ManitoSecurity/PCBDesign/ManufacturedBoards/mar25/ManitoBoardFinal/ManitoBoardFinal.brd

## EAGLE design ManufacturedBoards/mar25/ManitoBoardFinal/ManitoBoardFinal.brd (2015-03-25)

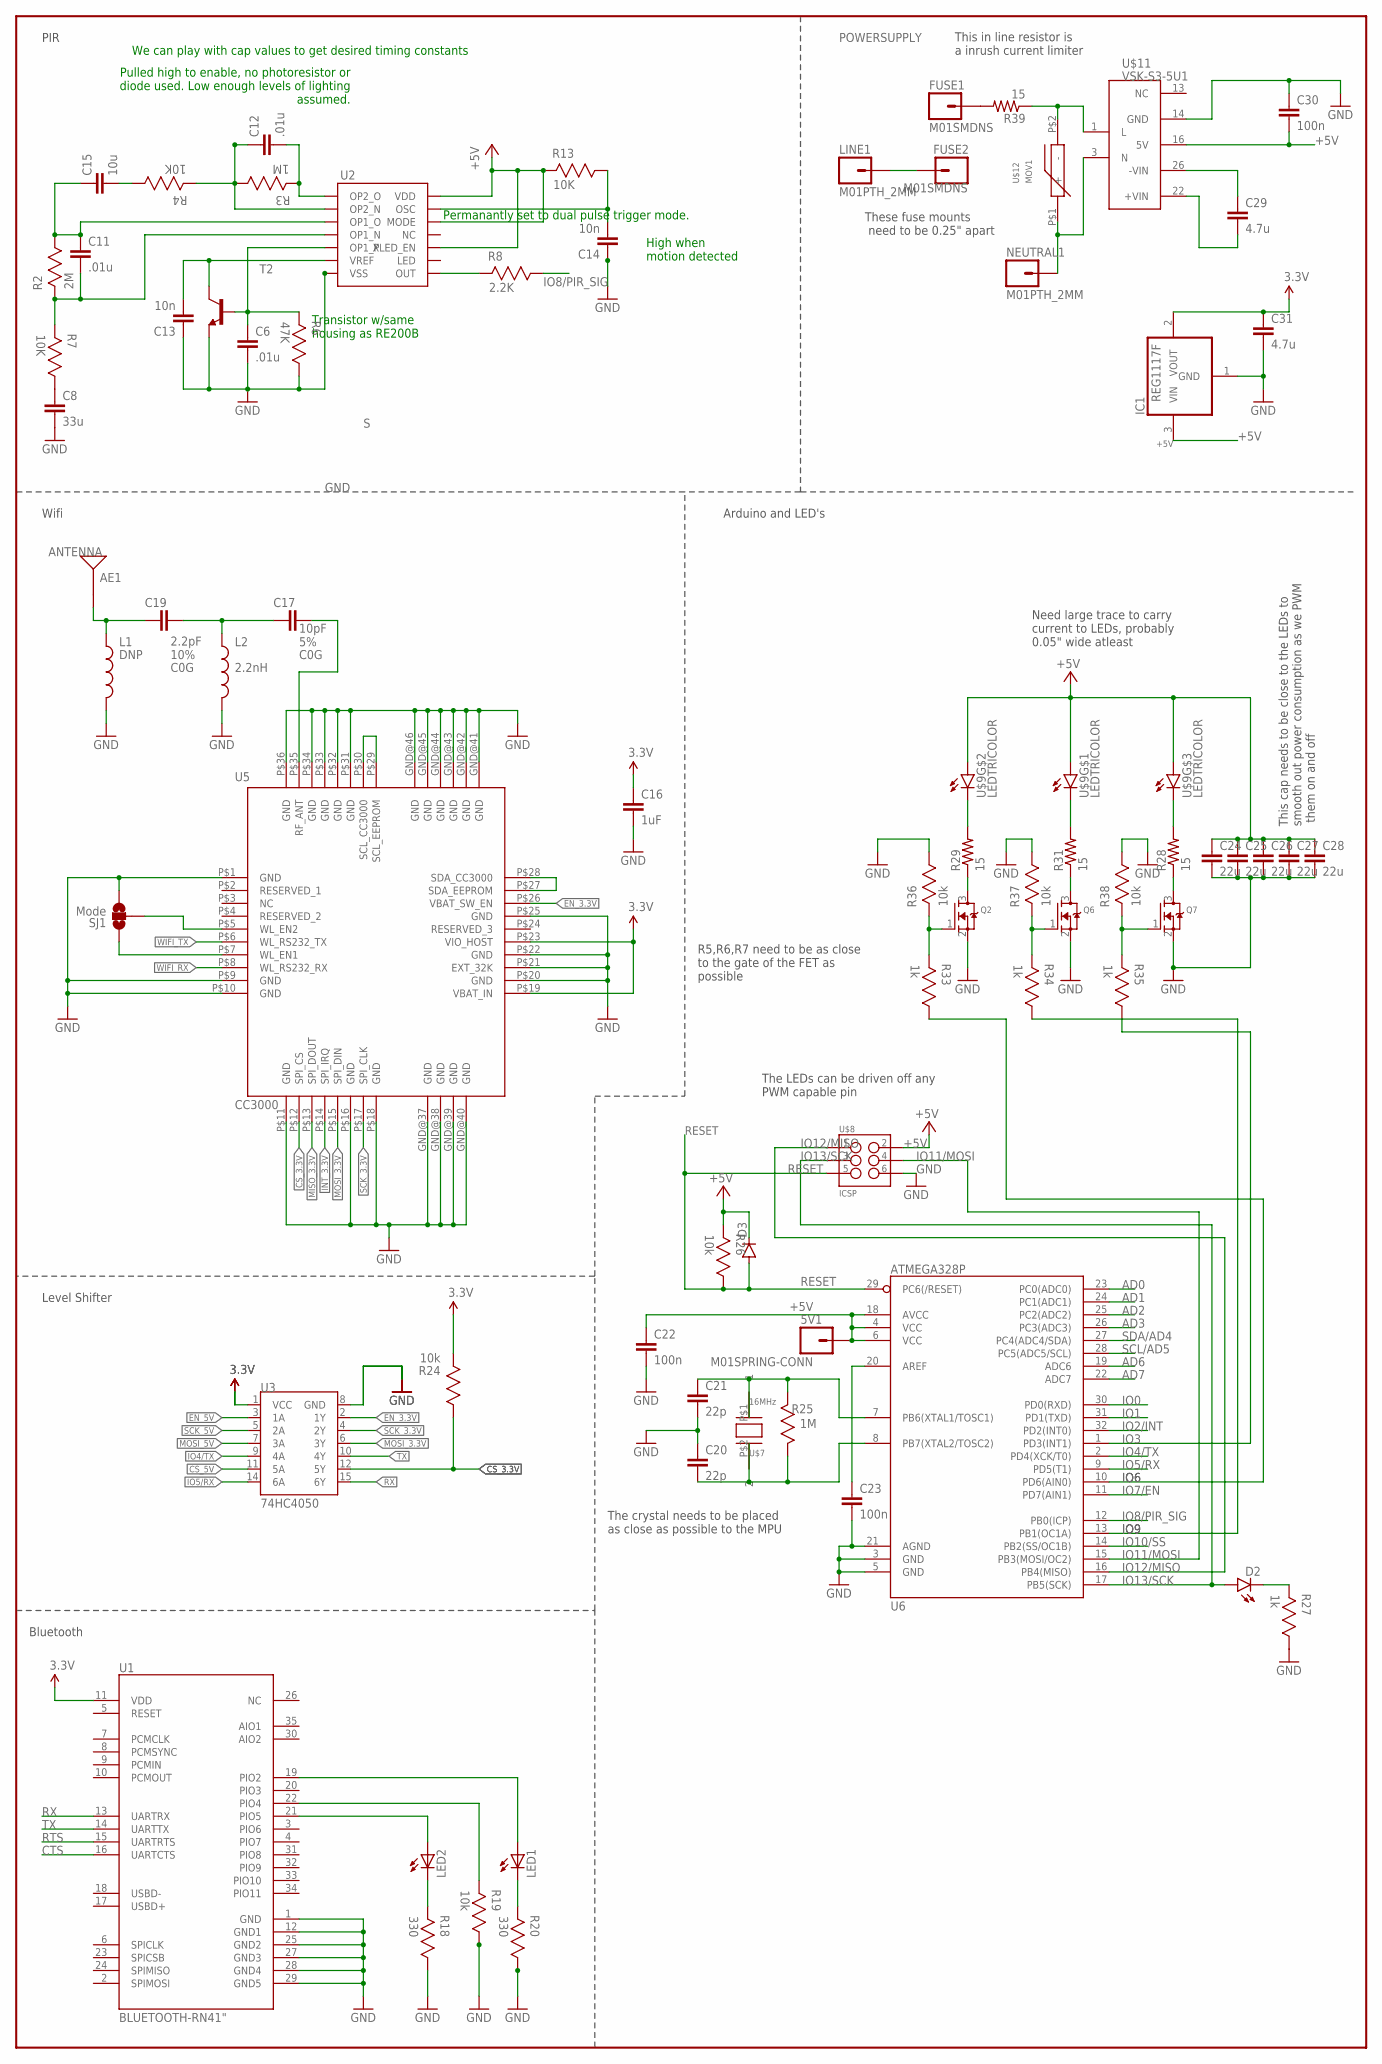
[picture p1: schematic ManitoBoardFinal.sch]

Parts:
5V1: M01SPRING-CONN; SPRING-CONNECTOR
AE1: ANTENNA; ANTENNA-CHIP_2500AT44M0400
C6, C11, C12: .01u; 0805
C8: 33u; 0805
C13, C14: 10n; 0805
C15: 10u; 0805
C16: 1uF; 0805
C17: 10pF; 0603-CAP
C19: 2.2pF; 0603-CAP
C20, C21: 22p; 0603-CAP
C22, C23, C30: 100n; 0603-CAP
C24, C25, C26, C27, C28: 22u; 0603-CAP
C29: 4.7u; AXIAL-5MM
C31: 4.7u; 0603-CAP
D2: LED-YELLOW0603; LED-0603
D3: DIODESOD123; SOD-123
FUSE1, FUSE2: M01SMDNS; 1X01NS
IC1: REG1117F; DD-3
L1: DNP; 0603
L2: 2.2nH; 0603
LED1, LED2: LED_ESML0603; LED_SML0603
LINE1: M01PTH_2MM; 1X01_2MM
NEUTRAL1: M01PTH_2MM; 1X01_2MM
Q2, Q6, Q7: MOSFET-NREFLOW; SOT23
R2: 2M; 0603RESISTOR
R3, R25: 1M; 0603RESISTOR
R4, R7, R13: 10K; 0603RESISTOR
R6: 47K; 0603RESISTOR
R8: 2.2K; 0603RESISTOR
R18, R20: 330; 0603RESISTOR
R19, R24, R26, R36, R37, R38: 10k; 0603RESISTOR
R27, R33, R34, R35: 1k; 0603RESISTOR
R28, R29, R31, R39: 15; AXIAL-0.6
SJ1: Mode; SJ_3_PASTE1&2
T2: -NPN-TO5; TO5
U1: BLUETOOTH-RN41"; RN41
U2: NCS36000; SO14
U3: 74HC4050; SO016
U5: CC3000; QFN-46_CC3000
U6: ATMEGA328P; TQFP32-08
U$7: 16MHz; SMDCRYSTAL
U$8: ICSP; 2X3-ICSP
U$9: LEDTRICOLOR; TRICOLORLED
U$11: VSK-S3-5U1; VSK-S3-DCAC
U$12: MOV1; MOV

Connections:
3.3V: C16.1, C31.1, IC1.2 (VOUT), R24.2, U1.11 (VDD), U3.1 (VCC), U5.P$19 (VBAT_IN), U5.P$23 (VIO_HOST)
+5V: 5V1.P$2, C22.1, C24.1, C25.1, C26.1, C27.1, C28.1, C30.2, D3.C, IC1.3 (VIN), R13.2, R26.2, U2.10 (XLED_EN), U2.12 (MODE), U2.14 (VDD), U6.4 (VCC), U6.6 (VCC), U6.18 (AVCC), U$8.2 (+5V), U$9.A1 (A), U$9.A2 (A), U$9.A3 (A), U$11.16 (5V)
AD0: U6.23 (PC0(ADC0))
AD1: U6.24 (PC1(ADC1))
AD2: U6.25 (PC2(ADC2))
AD3: U6.26 (PC3(ADC3))
AD6: U6.19 (ADC6)
AD7: U6.22 (ADC7)
CS_3.3V: R24.1, U3.12 (5Y), U5.P$12 (SPI_CS)
CS_5V: U3.11 (5A)
CTS: U1.16 (UARTCTS)
EN_3.3V: U3.2 (1Y), U5.P$26 (VBAT_SW_EN)
EN_5V: U3.3 (1A)
GND: C6.2, C8.2, C13.1, C14.1, C16.2, C20.1, C21.2, C22.2, C23.2, C24.2, C25.2, C26.2, C27.2, C28.2, C30.1, C31.2, IC1.1 (GND), L1.2, L2.2, Q2.2 (S), Q6.2 (S), Q7.2 (S), R6.1, R18.1, R19.1, R20.1, R27.1, R36.1, R37.1, R38.1, SJ1.3, T2.1 (E), U1.1 (GND), U1.12 (GND1), U1.25 (GND2), U1.27 (GND3), U1.28 (GND4), U1.29 (GND5), U2.7 (VSS), U3.8 (GND), U5.GND@37 (GND), U5.GND@38 (GND), U5.GND@39 (GND), U5.GND@40 (GND), U5.GND@41 (GND), U5.GND@42 (GND), U5.GND@43 (GND), U5.GND@44 (GND), U5.GND@45 (GND), U5.GND@46 (GND), U5.P$1 (GND), U5.P$9 (GND), U5.P$10 (GND), U5.P$11 (GND), U5.P$16 (GND), U5.P$18 (GND), U5.P$20 (GND), U5.P$21 (EXT_32K), U5.P$22 (GND), U5.P$25 (GND), U5.P$31 (GND), U5.P$32 (GND), U5.P$33 (GND), U5.P$34 (GND), U5.P$36 (GND), U6.3 (GND), U6.5 (GND), U6.21 (AGND), U$8.6 (GND), U$11.14 (GND)
INT_3.3V: U5.P$14 (SPI_IRQ)
IO0: U6.30 (PD0(RXD))
IO1: U6.31 (PD1(TXD))
IO2/INT: U6.32 (PD2(INT0))
IO3: R35.1, U6.1 (PD3(INT1))
IO4/TX: U3.9 (4A), U6.2 (PD4(XCK/T0))
IO5/RX: U3.14 (6A), U6.9 (PD5(T1))
IO6: R33.1, U6.10 (PD6(AIN0))
IO7/EN: U6.11 (PD7(AIN1))
IO8/PIR_SIG: R8.1, U6.12 (PB0(ICP))
IO9: R34.1, U6.13 (PB1(OC1A))
IO10/SS: U6.14 (PB2(SS/OC1B))
IO11/MOSI: U6.15 (PB3(MOSI/OC2)), U$8.4 (MOSI)
IO12/MISO: U6.16 (PB4(MISO)), U$8.1 (MISO)
IO13/SCK: D2.A, U6.17 (PB5(SCK)), U$8.3 (SCK)
MISO_3.3V: U5.P$13 (SPI_DOUT)
MOSI_3.3V: U3.6 (3Y), U5.P$15 (SPI_DIN)
MOSI_5V: U3.7 (3A)
unnamed: LED2.C, R18.2
unnamed: C13.2, T2.3 (C), U2.6 (VREF)
unnamed: C11.1, C15.1, R2.1, U2.3 (OP1_O)
unnamed: C11.2, R2.2, R7.2, U2.4 (OP1_N)
unnamed: C12.1, R3.1, R4.2, U2.2 (OP2_N)
unnamed: LED1.C, R20.2
unnamed: C12.2, R3.2, U2.1 (OP2_O)
unnamed: C8.1, R7.1
unnamed: LED2.A, U1.21 (PIO5)
unnamed: R19.2, U1.22 (PIO4)
unnamed: LED1.A, U1.19 (PIO2)
unnamed: C15.2, R4.1
unnamed: C14.2, R13.1, U2.13 (OSC)
unnamed: R8.2, U2.8 (OUT)
unnamed: SJ1.2, U5.P$5 (WL_EN2)
unnamed: SJ1.1, U5.P$7 (WL_EN1)
unnamed: U5.P$27 (SDA_EEPROM), U5.P$28 (SDA_CC3000)
unnamed: U5.P$29 (SCL_EEPROM), U5.P$30 (SCL_CC3000)
unnamed: C17.1, C19.2, L2.1
unnamed: AE1.FEED, C19.1, L1.1
unnamed: C17.2, U5.P$35 (RF_ANT)
unnamed: C20.2, R25.1, U6.8 (PB7(XTAL2/TOSC2)), U$7.P$2 (2)
unnamed: C21.1, R25.2, U6.7 (PB6(XTAL1/TOSC1)), U$7.P$1 (1)
unnamed: C23.1, U6.20 (AREF)
unnamed: D2.C, R27.2
unnamed: R29.P$2 (2), U$9.C2 (C)
unnamed: R31.P$2 (2), U$9.C1 (C)
unnamed: R28.P$2 (2), U$9.C3 (C)
unnamed: Q7.3 (D), R28.P$1 (1)
unnamed: Q6.3 (D), R31.P$1 (1)
unnamed: Q2.3 (D), R29.P$1 (1)
unnamed: Q2.1 (G), R33.2, R36.2
unnamed: Q7.1 (G), R35.2, R38.2
unnamed: Q6.1 (G), R34.2, R37.2
unnamed: C29.P$1 (1), U$11.26 (-VIN)
unnamed: C29.P$2 (2), U$11.22 (+VIN)
unnamed: R39.P$1 (1), U$11.1 (L), U$12.P$2 (-)
unnamed: NEUTRAL1.1, U$11.3 (N), U$12.P$1 (+)
unnamed: FUSE2.1, LINE1.1
unnamed: FUSE1.1, R39.P$2 (2)
RESET: D3.A, R26.1, U6.29 (PC6(/RESET)), U$8.5 (RESET)
RTS: U1.15 (UARTRTS)
RX: U1.13 (UARTRX), U3.15 (6Y)
S: C6.1, R6.2, T2.2 (B), U2.5 (OP1_P)
SCK_3.3V: U3.4 (2Y), U5.P$17 (SPI_CLK)
SCK_5V: U3.5 (2A)
SCL/AD5: U6.28 (PC5(ADC5/SCL))
SDA/AD4: U6.27 (PC4(ADC4/SDA))
TX: U1.14 (UARTTX), U3.10 (4Y)
WIFI_RX: U5.P$8 (WL_RS232_RX)
WIFI_TX: U5.P$6 (WL_RS232_TX)

Notes on the sheet:
Pulled high to enable, no photoresistor or diode used. Low enough levels of lighting assumed.
Permanantly set to dual pulse trigger mode.
High when motion detected
Transistor w/same housing as RE200B
We can play with cap values to get desired timing constants
Level Shifter
PIR
Arduino and LED's
Wifi
Bluetooth
This cap needs to be close to the LEDs to smooth out power consumption as we PWM them on and off
The crystal needs to be placed as close as possible to the MPU
The LEDs can be driven off any PWM capable pin
Need large trace to carry current to LEDs, probably 0.05" wide atleast
R5,R6,R7 need to be as close to the gate of the FET as possible
This in line resistor is a inrush current limiter
These fuse mounts need to be 0.25" apart

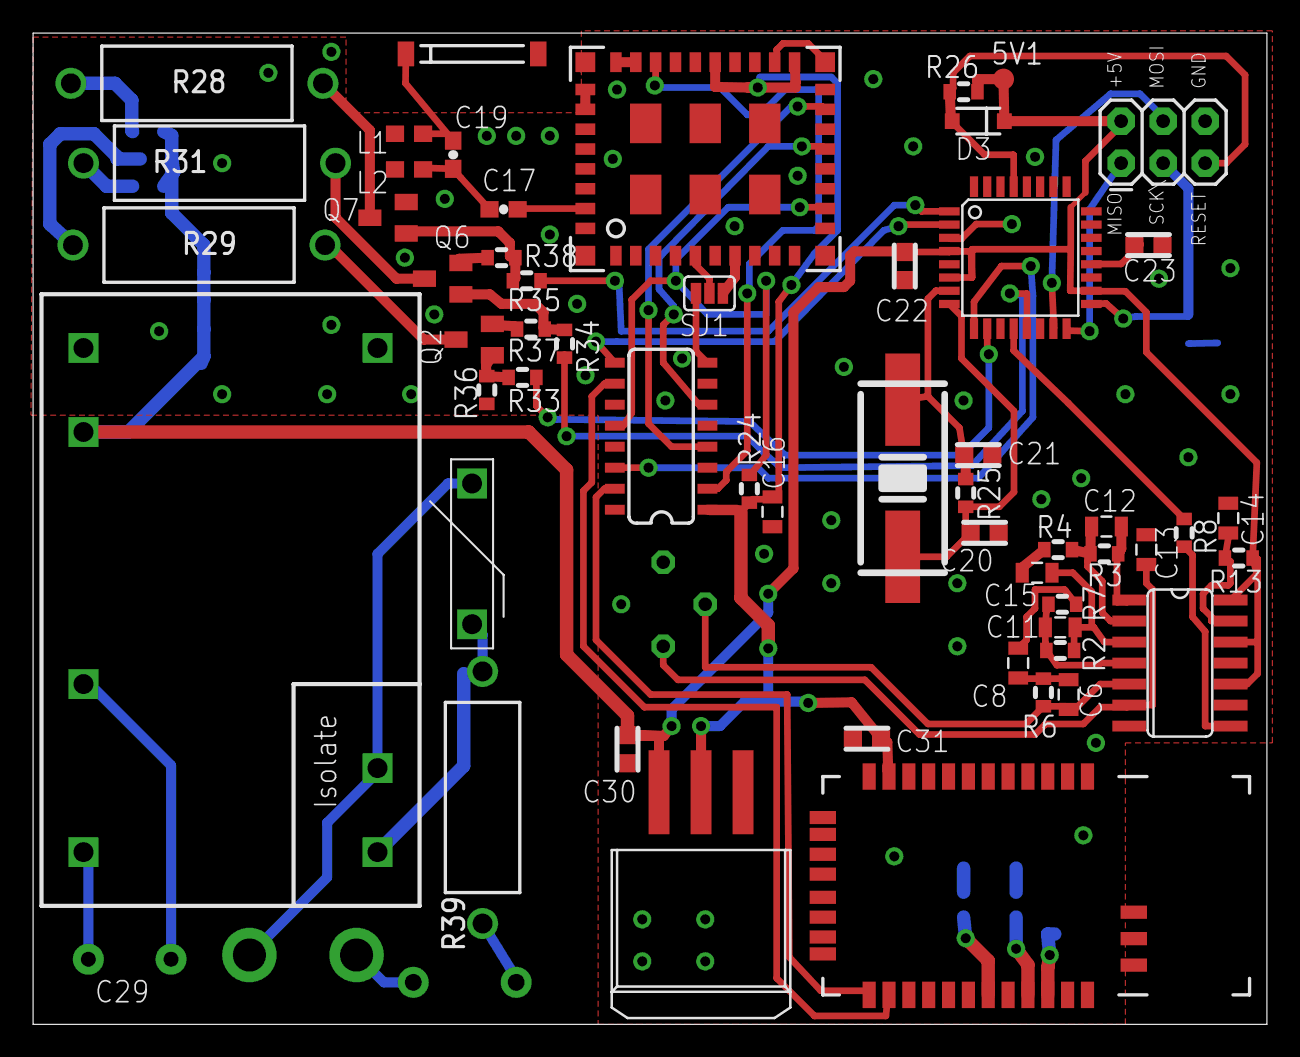
[picture p2: board ManitoBoardFinal.brd from above]

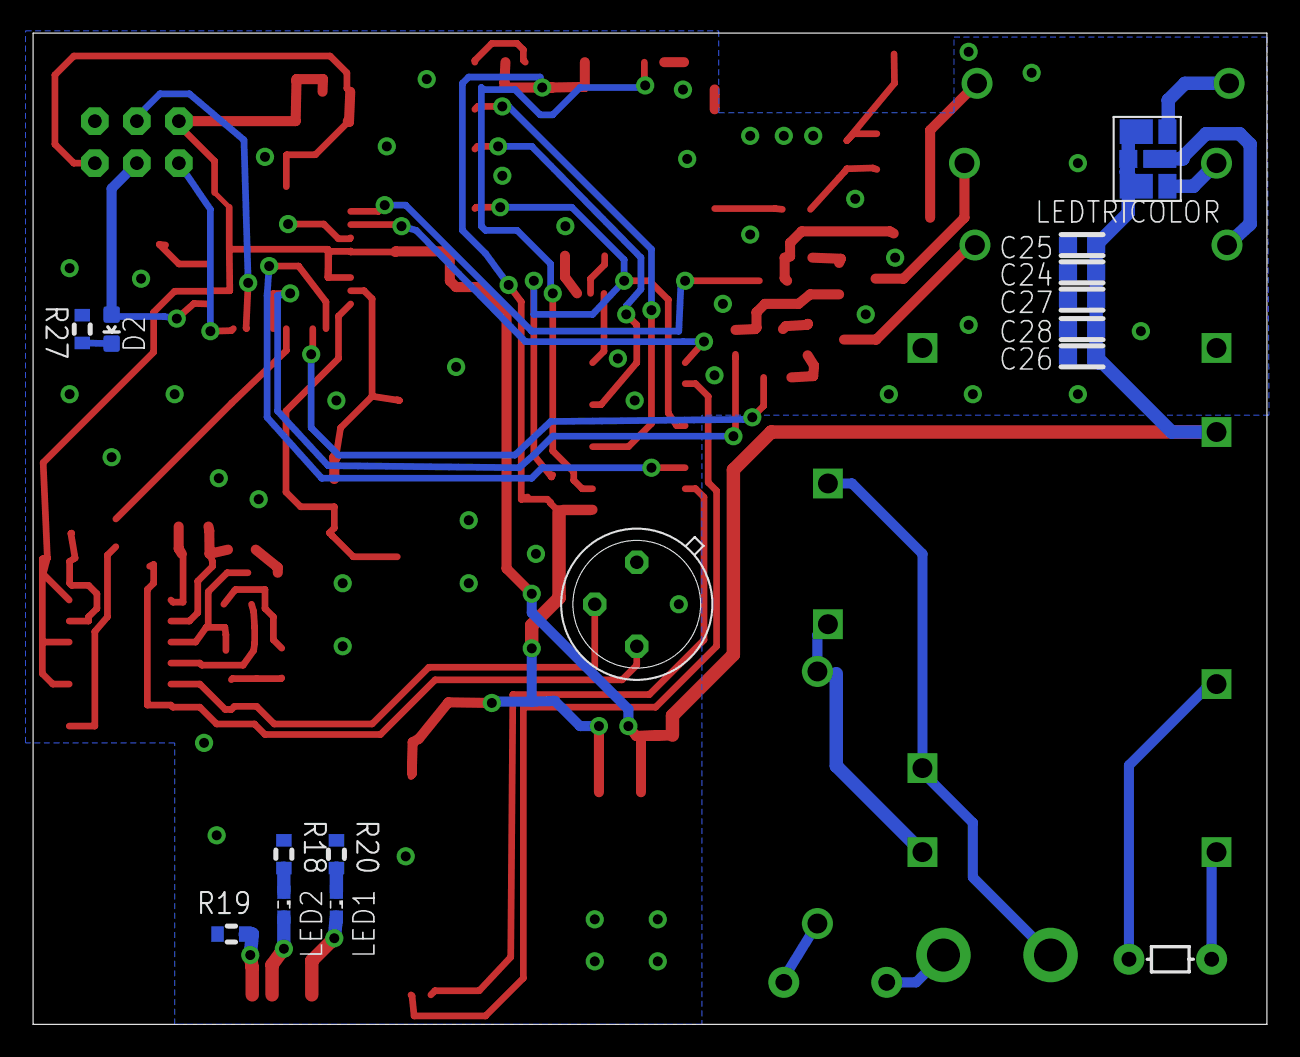
[picture p3: board ManitoBoardFinal.brd from below]

Board: 2 copper layers, 74.6 x 59.9 mm, 74 parts (15 on the bottom side), 60 nets.
