ManitoSecurity/PCBDesign/ManufacturedBoards/feb3/ManitoBoardv.7.brd

## EAGLE design ManufacturedBoards/feb3/ManitoBoardv.7.brd (2015-02-04)

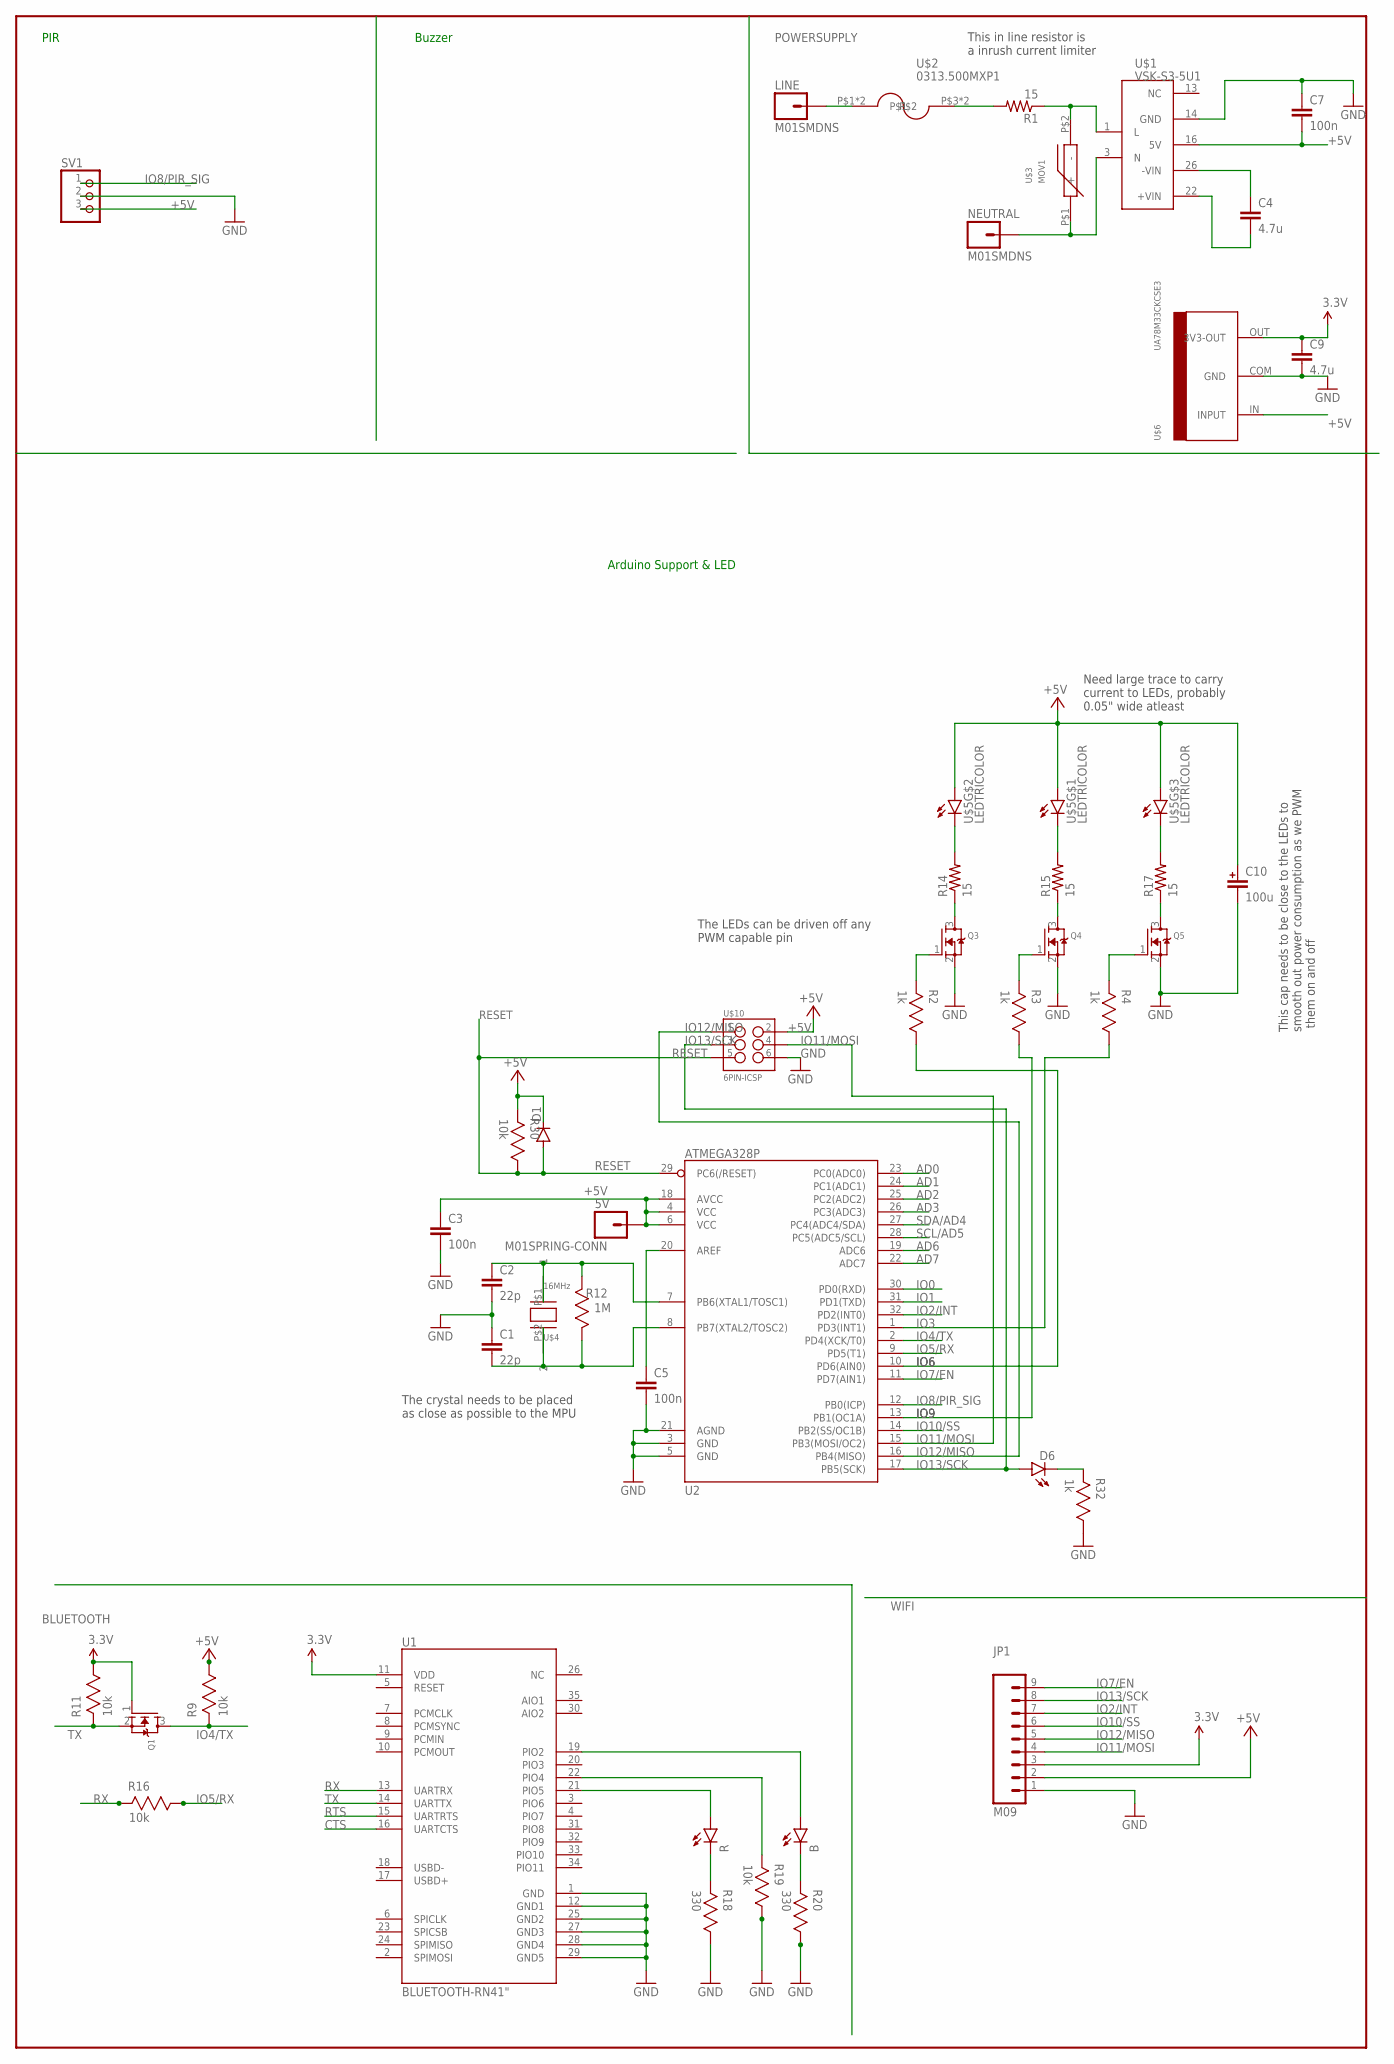
[picture p4: schematic ManitoBoardv.7.sch]

Parts:
5V: M01SPRING-CONN; SPRING-CONNECTOR
B: LED3MM
C1, C2: 22p; 0603-CAP
C3, C5, C7: 100n; 0603-CAP
C4, C9: 4.7u; 0603-CAP
C10: 100u; WXSERIES-SMDCAP
D1: DIODE1N4148; DIODE-1N4148
D6: LED-YELLOW0603; LED-0603
JP1: M09; 1X09
LINE: M01SMDNS; 1X01NS
NEUTRAL: M01SMDNS; 1X01NS
Q1, Q3, Q4, Q5: MOSFET-NREFLOW; SOT23
R: LED3MM
R1, R14, R15, R17: 15; AXIAL-0.6
R2, R3, R4, R32: 1k; 0603RESISTOR
R9, R11, R16, R19, R30: 10k; 0603RESISTOR
R12: 1M; 0603RESISTOR
R18, R20: 330; 0603RESISTOR
SV1: PINHD-1X3; 1X03
U1: BLUETOOTH-RN41"; RN41
U2: ATMEGA328P; TQFP32-08
U$1: VSK-S3-5U1; VSK-S3-DCAC
U$2: 0313.500MXP1; FUSEHOLDER0.25IN
U$3: MOV1; MOV
U$4: 16MHz; SMDCRYSTAL
U$5: LEDTRICOLOR; TRICOLORLED
U$6: UA78M33CKCSE3; TO220
U$10: 6PIN-ICSP; 2X3-ICSP

Connections:
+5V: 5V.P$2, C3.1, C7.2, C10.POS, D1.C, JP1.2, R9.1, R30.2, SV1.3, U2.4 (VCC), U2.6 (VCC), U2.18 (AVCC), U$1.16 (5V), U$5.A1 (A), U$5.A2 (A), U$5.A3 (A), U$6.IN (INPUT), U$10.2 (+5V)
AD0: U2.23 (PC0(ADC0))
AD1: U2.24 (PC1(ADC1))
AD2: U2.25 (PC2(ADC2))
AD3: U2.26 (PC3(ADC3))
AD6: U2.19 (ADC6)
AD7: U2.22 (ADC7)
CTS: U1.16 (UARTCTS)
GND: C1.1, C2.2, C3.2, C5.2, C7.1, C9.2, C10.NEG, JP1.1, Q3.2 (S), Q4.2 (S), Q5.2 (S), R18.1, R19.1, R20.1, R32.1, SV1.2, U1.1 (GND), U1.12 (GND1), U1.25 (GND2), U1.27 (GND3), U1.28 (GND4), U1.29 (GND5), U2.3 (GND), U2.5 (GND), U2.21 (AGND), U$1.14 (GND), U$6.COM (GND), U$10.6 (GND)
IO0: U2.30 (PD0(RXD))
IO1: U2.31 (PD1(TXD))
IO2/INT: JP1.7, U2.32 (PD2(INT0))
IO3: R4.1, U2.1 (PD3(INT1))
IO4/TX: Q1.3 (D), R9.2, U2.2 (PD4(XCK/T0))
IO5/RX: R16.1, U2.9 (PD5(T1))
IO6: R2.1, U2.10 (PD6(AIN0))
IO7/EN: JP1.9, U2.11 (PD7(AIN1))
IO8/PIR_SIG: SV1.1, U2.12 (PB0(ICP))
IO9: R3.1, U2.13 (PB1(OC1A))
IO10/SS: JP1.6, U2.14 (PB2(SS/OC1B))
IO11/MOSI: JP1.4, U2.15 (PB3(MOSI/OC2)), U$10.4 (MOSI)
IO12/MISO: JP1.5, U2.16 (PB4(MISO)), U$10.1 (MISO)
IO13/SCK: D6.A, JP1.8, U2.17 (PB5(SCK)), U$10.3 (SCK)
unnamed: C1.2, R12.1, U2.8 (PB7(XTAL2/TOSC2)), U$4.P$2 (2)
unnamed: R.K (C), R18.2
unnamed: C2.1, R12.2, U2.7 (PB6(XTAL1/TOSC1)), U$4.P$1 (1)
unnamed: Q5.3 (D), R17.P$1 (1)
unnamed: Q4.3 (D), R15.P$1 (1)
unnamed: Q3.3 (D), R14.P$1 (1)
unnamed: Q3.1 (G), R2.2
unnamed: Q5.1 (G), R4.2
unnamed: Q4.1 (G), R3.2
unnamed: C5.1, U2.20 (AREF)
unnamed: D6.C, R32.2
unnamed: C4.1, U$1.26 (-VIN)
unnamed: B.K (C), R20.2
unnamed: C4.2, U$1.22 (+VIN)
unnamed: R1.P$1 (1), U$1.1 (L), U$3.P$2 (-)
unnamed: NEUTRAL.1, U$1.3 (N), U$3.P$1 (+)
unnamed: LINE.1, U$2.P$1, U$2.P$2
unnamed: R1.P$2 (2), U$2.P$3, U$2.P$4
unnamed: R14.P$2 (2), U$5.C2 (C)
unnamed: R15.P$2 (2), U$5.C1 (C)
unnamed: R17.P$2 (2), U$5.C3 (C)
unnamed: R.A, U1.21 (PIO5)
unnamed: R19.2, U1.22 (PIO4)
unnamed: B.A, U1.19 (PIO2)
RESET: D1.A, R30.1, U2.29 (PC6(/RESET)), U$10.5 (RESET)
RTS: U1.15 (UARTRTS)
RX: R16.2, U1.13 (UARTRX)
SCL/AD5: U2.28 (PC5(ADC5/SCL))
SDA/AD4: U2.27 (PC4(ADC4/SDA))
TX: Q1.2 (S), R11.2, U1.14 (UARTTX)
VCC: C9.1, JP1.3, Q1.1 (G), R11.1, U1.11 (VDD), U$6.OUT (3V3-OUT)

Notes on the sheet:
This cap needs to be close to the LEDs to smooth out power consumption as we PWM them on and off
This in line resistor is a inrush current limiter
The crystal needs to be placed as close as possible to the MPU
The LEDs can be driven off any PWM capable pin
Need large trace to carry current to LEDs, probably 0.05" wide atleast
Arduino Support & LED
Buzzer
PIR

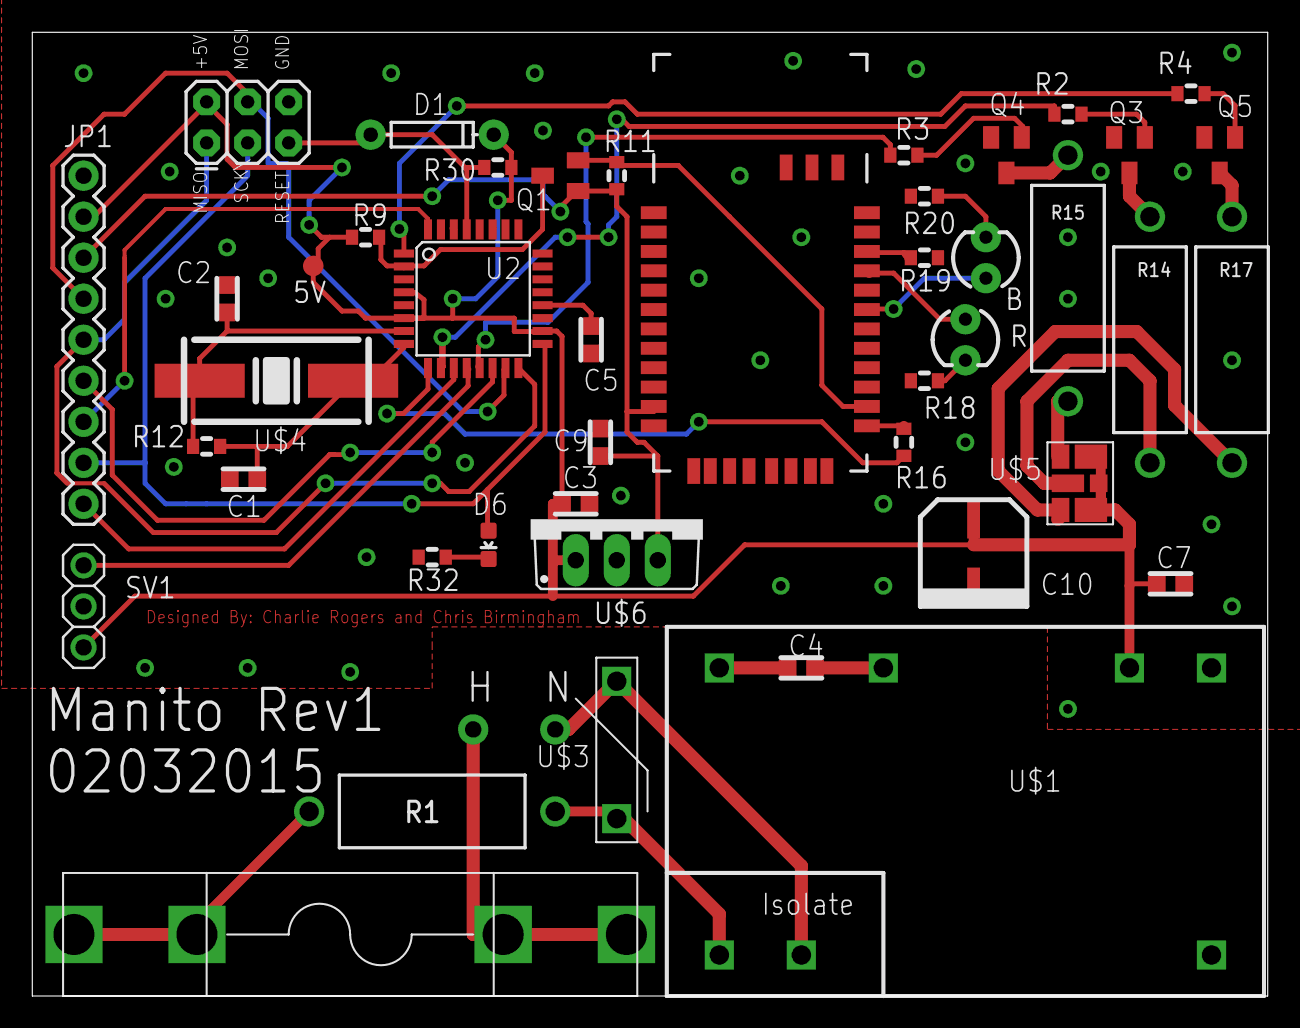
[picture p5: board ManitoBoardv.7.brd from above]

Board: 2 copper layers, 76.5 x 59.7 mm, 46 parts (0 on the bottom side), 42 nets.
