ManitoSecurity/PCBDesign/(commit log)

2015-01-19 Board Development
    [PIRprotov1.sch, Proto1.sch]
2015-01-27 Board with Layout
    First complete layout now version .6
    [ManitoBoardv.5.brd, ManitoBoardv.6.brd, ManitoBoardv.6.sch]
2015-02-01 Better Board Layout
    [ManitoBoardv.7.brd, ManitoBoardv.7.sch]
2015-02-02 IncompleteRevisions
    Attempting to shrink board size, reduce variety of trace widths,
    simplify angles, remove curved corners, improve thermal relief
    [ManitoBoardv.7.brd, ManitoBoardv.7.sch]
2015-02-03 Fixed Layout Issues
    [ManitoBoardv.7.brd]
2015-02-04 Finished Rev1
    [ManitoBoardv.5.brd, ManitoBoardv.5.sch, ManitoBoardv.6.brd, ManitoBoardv.6.sch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]
2015-02-25 Updated Schematics for Next Revision
2015-03-06 2nd pcb design iteration
    7.1 design is mostly complete, some changes are still required and must
    undergo DRC. Basic layout should be solid.
    [ManitoBoardv.7.1.brd, ManitoBoardv.7.1.sch]
2015-03-23 Last Prototype First Attempt
    DRC check must be finished, capacitor under power supply should be
    through hole?, checking hole sizes where needed.
    [ManitoBoardLP1.brd, ManitoBoardLP1.sch]
2015-03-23 Second design iteration of final board
    Fixed GND issues and more
    [ManitoBoardL2.brd, ManitoBoardL2.sch]
2015-03-24 Close to final edits
    [ManitoBoardL3.brd, ManitoBoardL3.sch]
2015-03-25 Final Board
    [ManitoBoardFinal.brd, ManitoBoardFinal.sch]
